ZioGuido/FostexCTRL/PCB/Fostex_CTRL.png

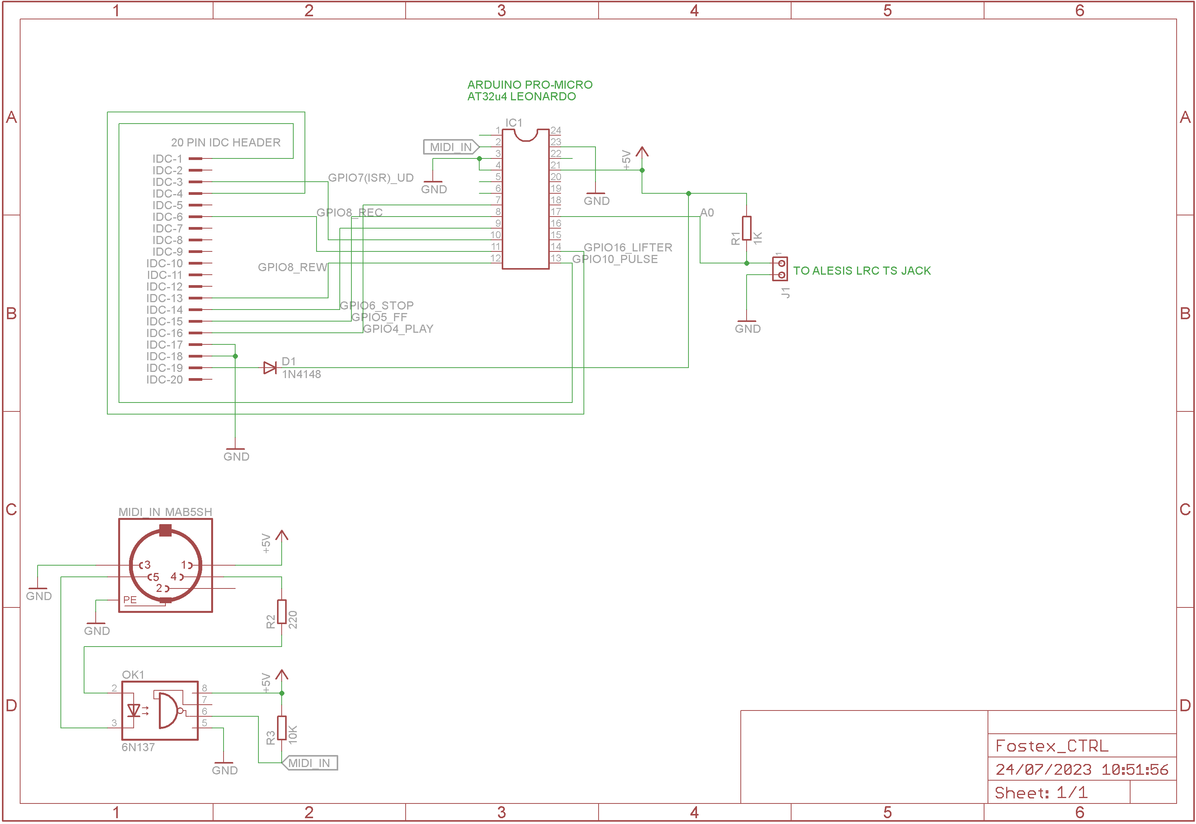
PCB/Fostex_CTRL.png
