ZioGuido/FostexCTRL/PCB/R8_20pin_synchro.png

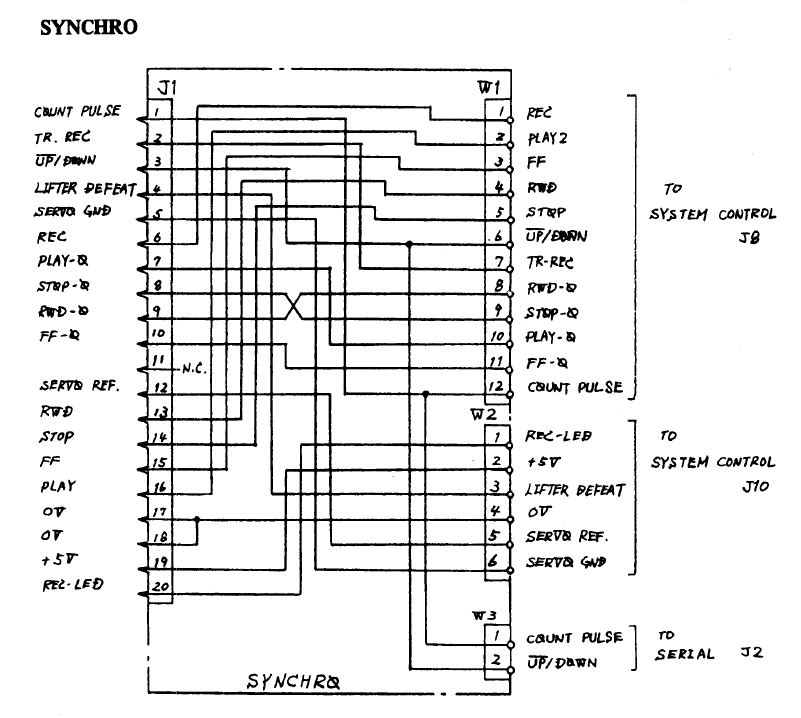
PCB/R8_20pin_synchro.png
