ZioGuido/FostexCTRL/PCB/Fostex_CTRL.sch

## EAGLE design PCB/Fostex_CTRL.sch (2023-07-25)

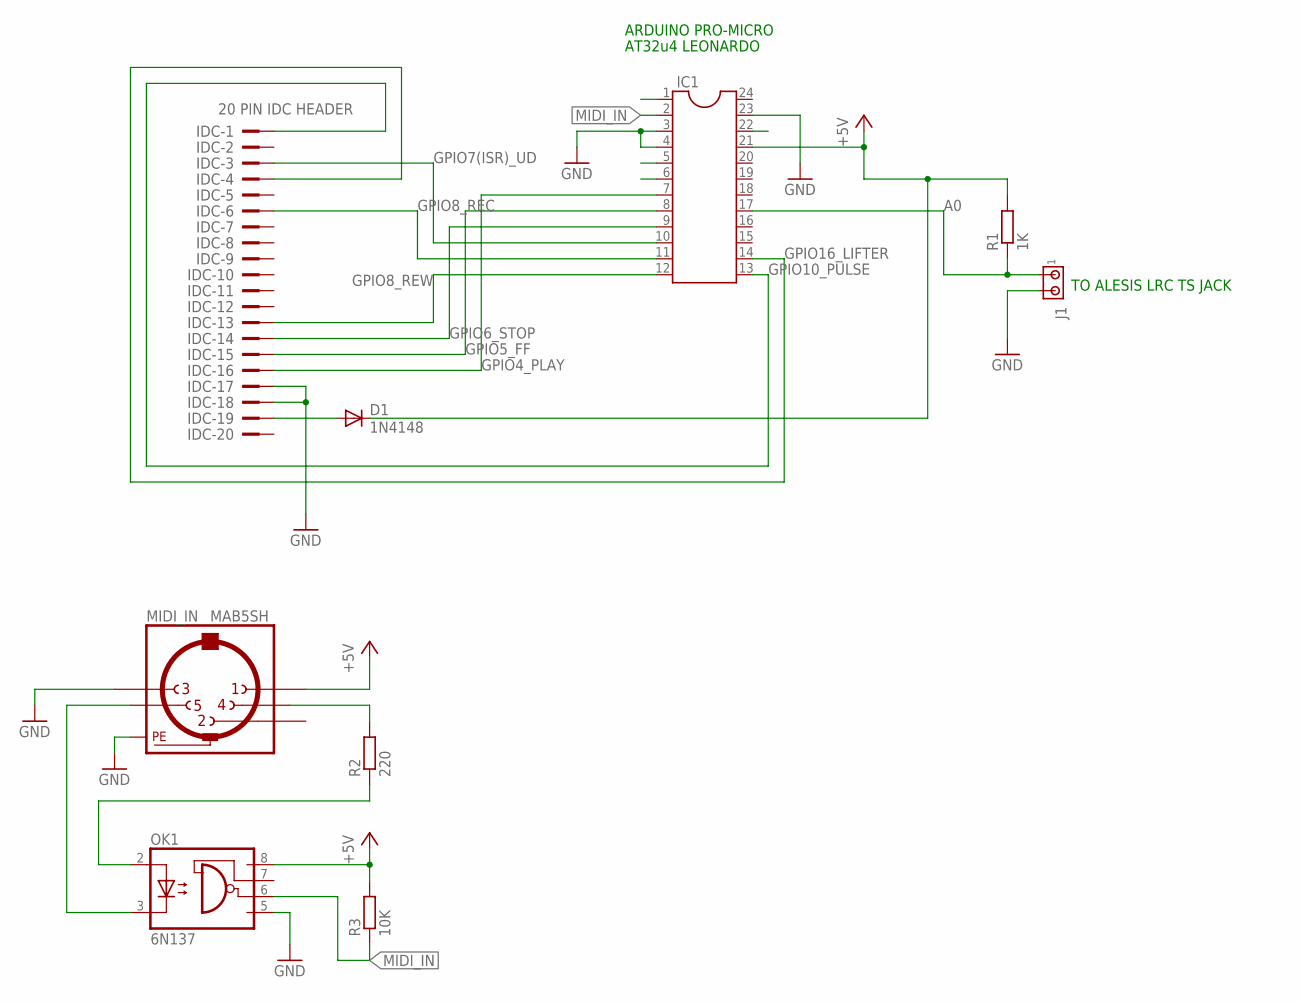
[picture p3: schematic Fostex_CTRL.sch]

Parts:
D1: 1N4148; DO35-7
IC1: DIL24-6
IDC: 20 PIN IDC HEADER; PAK100/2500-20
J1: MTA02-100; 10X02MTA
MIDI_IN: MAB5SH
OK1: 6N137; DIL08
R1: 1K; 0207/7
R2: 220; 0207/7
R3: 10K; 0207/7

Connections:
+5V: D1.C, IC1.21, MIDI_IN.1, OK1.8 (VCC), R1.2, R3.2
A0: IC1.17, J1.1, R1.1
GND: IC1.3, IC1.4, IC1.23, IDC.17, IDC.18, J1.2, MIDI_IN.3, MIDI_IN.PE, OK1.5 (GND)
GPIO4_PLAY: IC1.7, IDC.16
GPIO5_FF: IC1.8, IDC.15
GPIO6_STOP: IC1.9, IDC.14
GPIO7(ISR)_UD: IC1.10, IDC.3
GPIO8_REC: IC1.11, IDC.6
GPIO8_REW: IC1.12, IDC.13
GPIO10_PULSE: IC1.13, IDC.1
GPIO16_LIFTER: IC1.14, IDC.4
MIDI_IN: IC1.2, OK1.6 (VO), R3.1
MIDI_OUT: IC1.1
unnamed: D1.A, IDC.19
unnamed: MIDI_IN.5, OK1.3 (C)
unnamed: OK1.2 (A), R2.1
unnamed: MIDI_IN.4, R2.2
P0: IC1.5
P1: IC1.6
RST: IC1.22

Notes on the sheet:
ARDUINO PRO-MICRO
AT32u4 LEONARDO
TO ALESIS LRC TS JACK
